aseemj745/ecg-arrhythmia-detection-model-uno-q/sensor-testing/ecg-monitor/sample_ecg.csv

ecg
-0.0892055568659291
-0.04882826913279664
0.012740637017144528
0.05561062897406077
0.0917168608766617
0.014372538089241126
-0.05701929591149592
-0.05890783106079889
0.011986923136419381
-0.0027531000741553026
-0.14667481864781848
0.04889316642481679
-0.03412600914953302
0.019939076284724105
-0.016926171416921647
0.09601763482026188
-0.01733121165227605
-0.010781130648219206
0.1596325081069057
-0.038071708831243584
0.04819654458539284
-0.00253398057685023
-0.057331106048696935
0.0108300499202326
0.008447925724556982
0.013700711043794327
-0.04027391691109176
0.04253564243158053
-0.019829113275766325
0.037398082193652385
0.000629036827738516
0.025318233553057252
-0.029454876980937718
-0.07850418847336738
0.13563324659106799
0.059028656046194276
0.06419799753863188
-0.05132558208772956
-0.011285150116635601
0.017650831291846202
0.06954560680212245
0.04341106785041437
0.04319631650071315
-0.051271704426693876
-0.11479790782977793
0.08890668272874651
-0.032456933596761404
0.008582060396730883
0.01613421712168771
-0.0487379969155829
0.05277314454267058
-0.026873848391623163
0.05716102530410053
0.06080315794620472
-0.10624442721408911
-0.020681940791084364
-0.0011630986992441743
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
