aseemj745/ecg-arrhythmia-detection-model-uno-q/(commit log)

2026-08-20 initial commit - ECG arrhythmia classifier for the Arduino UNO Q
    5-class per-beat model trained on MIT-BIH, exported to a 91KB INT8 ONNX.
    macro F1 0.757 on held-out patients.
    [sample_ecg_250hz.csv]
2026-08-20 fix 125Hz sample rate, add MCU sketch and demo record picker
    Rate was 250 in the code but the sketch runs at 125, so every heart rate was
    coming out 2x too fast. Also adds a live confidence gate and the dashboard
    controls.
    [demo_114.csv, demo_119.csv, demo_202.csv, demo_214.csv, demo_221.csv, demo_231.csv, demo_233.csv, demo_234.csv]
2026-08-20 confirm live sensor and motion gating work on the board
2026-08-20 simplify live sensor limitations note
2026-08-21 simplify docs and tidy up comments
    Plainer language in the READMEs and shorter code comments. No code changes.
    [config.py, data.py, main.py]
2026-08-21 shorten comments and plainer wording in the docs
    [config.py, data.py, main.py, pipeline.py]
2026-08-22 add sensor calibration and verification apps used to validate the signal chain
    [sample_ecg.csv]
2026-08-22 add photos of the actual wired hardware setup
